Dschadu/Geistwerk-BigCore/PCB.png

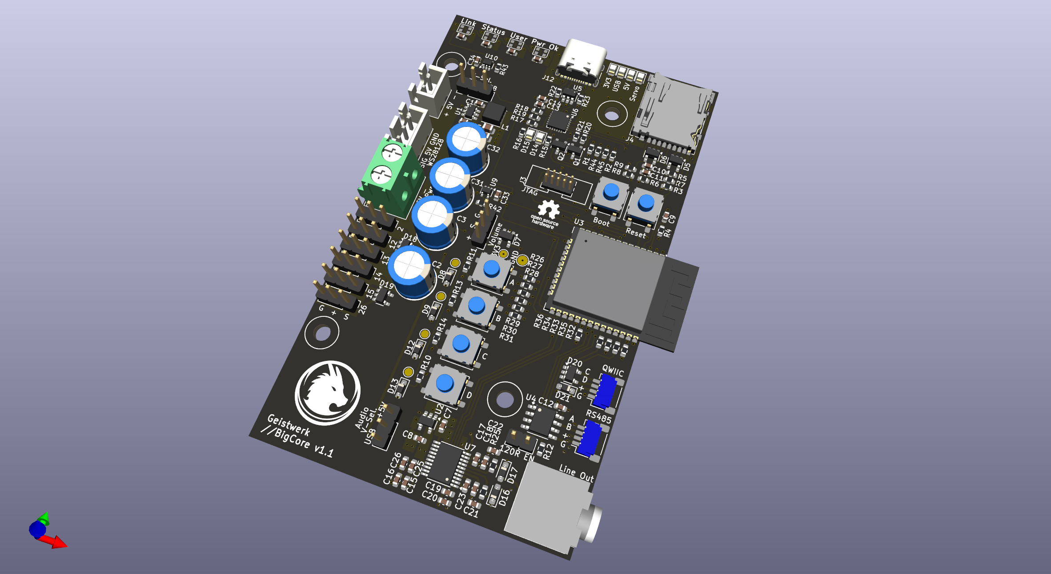
PCB.png
