Dschadu/Geistwerk-BigCore/BigCore.kicad_pcb

## KiCad design BigCore.kicad_pcb (2026-05-09)

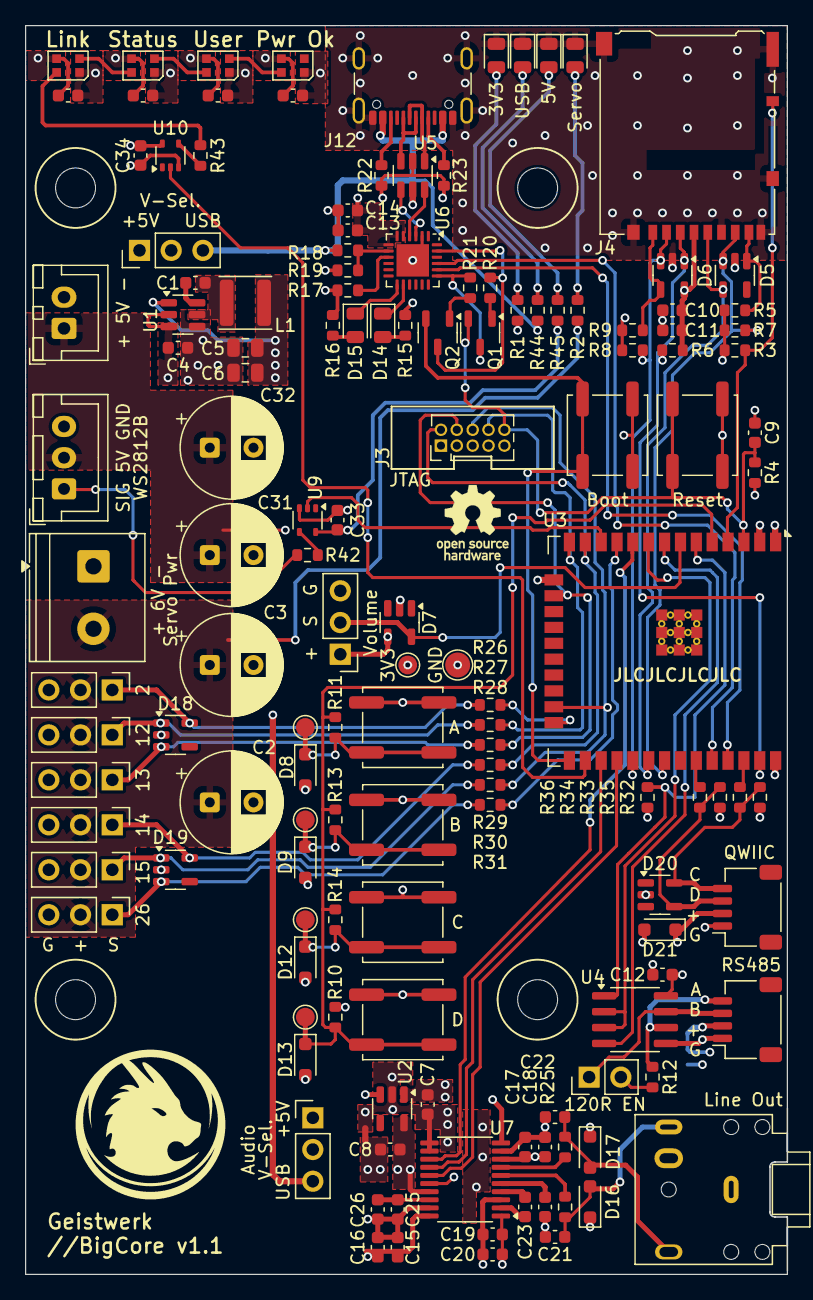
[picture p10: board BigCore.kicad_pcb from above]

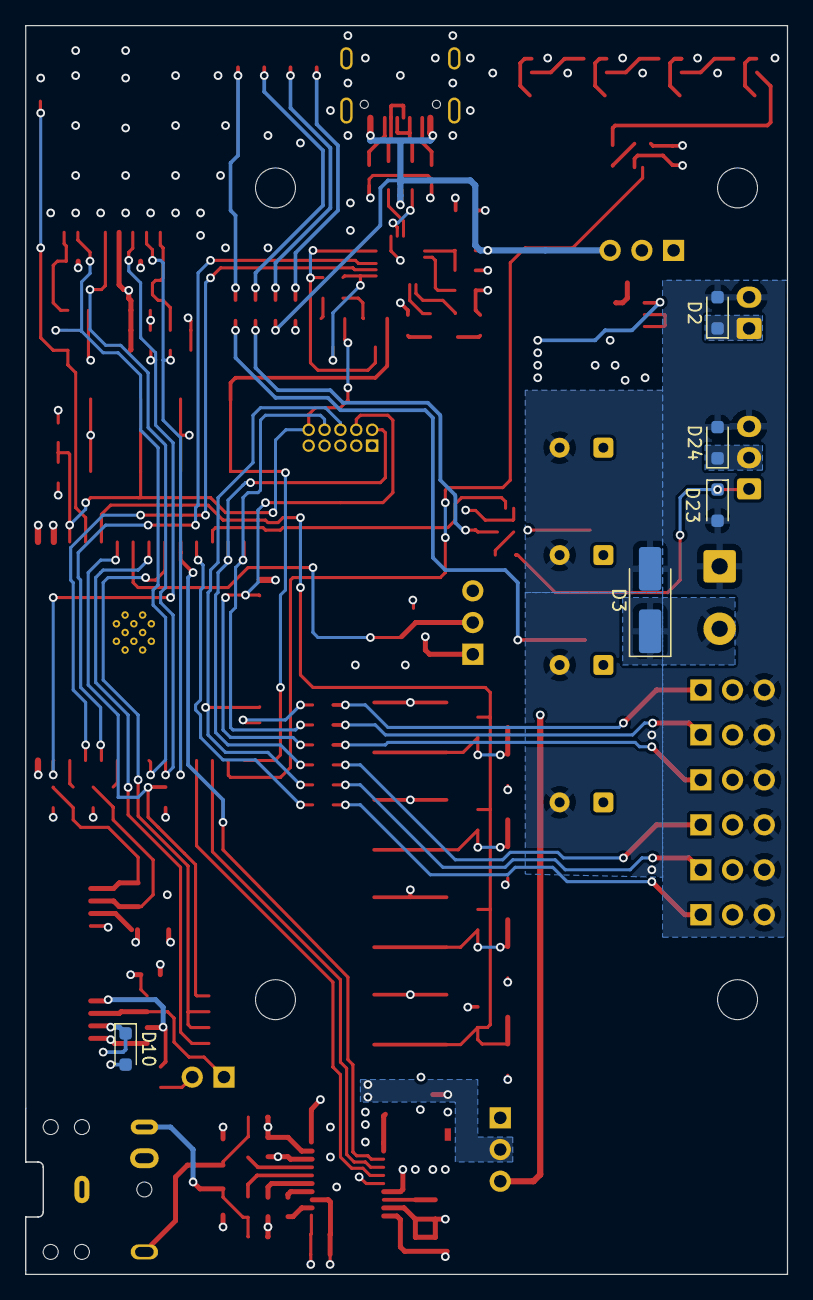
[picture p11: board BigCore.kicad_pcb from below]

Board: 4 copper layers, 61.0 x 100.0 mm, 151 parts (5 on the bottom side), 89 nets.

Parts:
C1, C9, C10, C12, C13, C15, C17, C19, C25, C33, C34, C35, C36, C37, C38: 100n; C_0603_1608Metric
C2, C3, C31, C32: 470µ; CP_Radial_D8.0mm_P3.50mm
C4, C11, C14, C16, C18, C20, C26: 10µ; C_0603_1608Metric
C5, C6: 22µ; C_0805_2012Metric
C7, C8: 1µ; C_0603_1608Metric
C21, C22: 2.2n; C_0603_1608Metric
C23, C24: 2.2µ; C_0603_1608Metric
D1, D4, D29, D30: Green; LED_0805_2012Metric
D2, D23, D24: TSD05DYFR; D_SOD-323_HandSoldering
D3: SMCJ13A; D_SMA_Handsoldering
D5, D6, D18, D19: ESDS314; SOT-23-5
D7, D20: ESDS312; SOT-23-5
D8, D9, D10, D12, D13, D21: ESDS311DYFR; D_SOD-323_HandSoldering
D14: TX; LED_0805_2012Metric
D15: RX; LED_0805_2012Metric
D16, D17: SD08LCC; D_SOD-323_HandSoldering
D25, D26, D27, D28: WS2812B; LED_WS2812B-2020_PLCC4_2.0x2.0mm
H1, H2, H3, H4: MountingHole; MountingHole_3.2mm_M3
H5: Logo_Open_Hardware_Small; OSHW-Logo_5.7x6mm_SilkScreen
J1: 5V In; JST_XH_B2B-XH-A_1x02_P2.50mm_Vertical
J2: Vdrive In; TerminalBlock_Phoenix_PT-1,5-2-5.0-H_1x02_P5.00mm_Horizontal
J3: JTAG; PinHeader_2x05_P1.27mm_Vertical
J4: DM3AT-SF-PEJM5; microSD_HC_Hirose_DM3AT-SF-PEJM5
J5: Volume; PinHeader_1x03_P2.54mm_Vertical
J6: Btn 0; TestPoint_Pad_D1.5mm
J7: RS485; JST_SH_SM04B-SRSS-TB_1x04-1MP_P1.00mm_Horizontal
J8: Btn 1; TestPoint_Pad_D1.5mm
J9: Btn 2; TestPoint_Pad_D1.5mm
J10: Btn 3; TestPoint_Pad_D1.5mm
J11: GND; TestPoint_Pad_D2.0mm
J12: USB_C_Receptacle_USB2.0; USB_C_Receptacle_GCT_USB4105-xx-A_16P_TopMnt_Horizontal
J13: Line Out; Jack_3.5mm_CUI_SJ1-3524N_Horizontal
J14: Servo 01; PinHeader_1x03_P2.54mm_Vertical
J15: Servo 02; PinHeader_1x03_P2.54mm_Vertical
J16: Servo 03; PinHeader_1x03_P2.54mm_Vertical
J17: Servo 04; PinHeader_1x03_P2.54mm_Vertical
J18: Servo 05; PinHeader_1x03_P2.54mm_Vertical
J19: Servo 06; PinHeader_1x03_P2.54mm_Vertical
J20: I2C; JST_SH_SM04B-SRSS-TB_1x04-1MP_P1.00mm_Horizontal
J22: WS2812; JST_XH_B3B-XH-A_1x03_P2.50mm_Vertical
JP1: RS485; PinHeader_1x02_P2.54mm_Vertical
JP2: 5V Selection Digital; PinHeader_1x03_P2.54mm_Vertical
JP3: 5V Selection Analog; PinHeader_1x03_P2.54mm_Vertical
L1: 2,2µ; L_APV_ANR4020
NT1: NetTie_2; NetTie-2_SMD_Pad0.5mm
Q1, Q2: SS8050-G; SOT-23-3
R1, R12, R15, R16, R42, R43: 120; R_0603_1608Metric
R2, R24, R25, R44, R45: 470; R_0603_1608Metric
R3, R4, R5, R6, R7, R8, R9, R20, R21, R36: 10k; R_0603_1608Metric
R10, R17: 1k; R_0603_1608Metric
R11: 4,99k; R_0603_1608Metric
R13: 1,15k; R_0603_1608Metric
R14: 300; R_0603_1608Metric
R18: 22.1k; R_0603_1608Metric
R19: 47.5k; R_0603_1608Metric
R22, R23: 5,1k; R_0603_1608Metric
R26, R27, R28, R29, R30, R31, R34, R35: 33; R_0603_1608Metric
R32, R33: 1.6k; R_0603_1608Metric
SW1: Reset; SW_Push_1P1T_NO_CK_KSC7xxJ
SW2: Boot; SW_Push_1P1T_NO_CK_KSC7xxJ
SW3: Btn 0; SW_Push_1P1T_NO_CK_KSC7xxJ
SW4: Btn 1; SW_Push_1P1T_NO_CK_KSC7xxJ
SW5: Btn 2; SW_Push_1P1T_NO_CK_KSC7xxJ
SW6: Btn 3; SW_Push_1P1T_NO_CK_KSC7xxJ
TP1: +3V3; TestPoint_Pad_D1.5mm
U1: AP63203WU; TSOT-23-6
U2: AP2112K-3.3; SOT-23-5
U3: ESP32-WROOM-32E
U4: ST3485EBDR; SOIC-8_3.9x4.9mm_P1.27mm
U5: USBLC6-2SC6; SOT-23-6
U6: CP2102N-Axx-xQFN24; QFN-24-1EP_4x4mm_P0.5mm_EP2.6x2.6mm
U7: PCM5102A; TSSOP-20_4.4x6.5mm_P0.65mm
U9, U10: 74AHCT1G17; SOT-353_SC-70-5

Connections:
+3.3V: C5.1, C6.1, C10.1, C11.1, C12.1, C13.1, C14.1, C15.1, C16.1, D6.5 (K), D7.4 (K), D10.1 (K), D21.1 (K), J3.1, J4.4 (VDD), J5.1, J7.2, J20.2, L1.2, R1.1, R3.1, R4.1, R5.1, R6.1, R7.1, R8.1, R9.1, R10.1, R15.1, R16.1, R17.1, R32.1, R33.1, R36.1, TP1.1, U1.1 (FB), U3.2 (VDD), U4.8 (VCC), U6.5 (VIO), U6.6 (VDD), U6.7 (VREGIN), U7.20 (DVDD)
+3.3VA: C8.1, C17.1, C18.1, C19.1, C20.1, U2.5 (VOUT), U7.1 (CPVDD), U7.8 (AVDD), U7.17 (XSMT)
+5V: C31.1, C32.1, C33.1, D2.1 (K), D24.1 (K), J1.1, J22.2, JP2.1 (A), JP3.1 (A), R45.1, U9.5 (VCC)
+5VD: C4.1, C34.1, C35.1, C36.1, C37.1, C38.1, D25.1 (VDD), D26.1 (VDD), D27.1 (VDD), D28.1 (VDD), JP2.2 (C), U1.2 (EN), U1.3 (IN), U10.5 (VCC)
/Controller/BOOT: Q2.2 (C), SW2.1, U3.25 (IO0)
/Controller/Buttons: D13.1 (K), J10.1, R10.2, R11.1, R13.1, R14.1, SW6.2, U3.5 (SENSOR_VN)
/Controller/EN: C9.1, J3.10, Q1.2 (C), R4.2, SW1.1, U3.3 (EN)
/Controller/I2S_BitClock: U3.10 (IO25), U7.13 (BCK)
/Controller/I2S_Data: U3.27 (IO16), U7.14 (DIN)
/Controller/I2S_LeftRightClock: U3.28 (IO17), U7.15 (LRCK)
/Controller/LED_STATUS: U3.26 (IO4), U10.2
/Controller/RS485_A: J7.4, R12.2, U4.6 (A)
/Controller/RS485_B: J7.3, JP1.1 (A), U4.7 (B)
/Controller/RS485_D: U3.8 (IO32), U4.4 (D)
/Controller/RS485_R: R36.2, U3.6 (IO34), U4.1 (R)
/Controller/RS485_~REDE: U3.9 (IO33), U4.2 (~RE), U4.3 (DE)
/Controller/RXD: U3.34 (RXD0/IO3), U6.21 (TXD)
/Controller/SCL: R35.1, U3.36 (IO22)
/Controller/SDA: R34.1, U3.33 (IO21)
/Controller/SD_CD: D6.3 (K), J4.2 (DAT3/CD), R8.2, U3.29 (IO5)
/Controller/SD_CLK: D5.4 (K), J4.5 (CLK), U3.30 (IO18)
/Controller/SD_CMD: D6.1 (K), J4.3 (CMD), R6.2, U3.37 (IO23)
/Controller/SD_DAT0: D5.3 (K), J4.7 (DAT0), R7.2, U3.31 (IO19)
/Controller/SD_Detect: J4.10 (DET_A), R3.2, U3.4 (SENSOR_VP)
/Controller/Servo_01: R26.1, U3.24 (IO2)
/Controller/Servo_02: J3.8, R27.1, U3.14 (IO12)
/Controller/Servo_03: J3.4, R28.1, U3.16 (IO13)
/Controller/Servo_04: J3.2, R29.1, U3.13 (IO14)
/Controller/Servo_05: J3.6, R30.1, U3.23 (IO15)
/Controller/Servo_06: R31.1, U3.11 (IO26)
/Controller/TXD: U3.35 (TXD0/IO1), U6.20 (RXD)
/Controller/Volume: D7.5 (K), J5.2, U3.7 (IO35)
/Controller/WS2812_Bus: U3.12 (IO27), U9.2
/Power Supply/5VA_In: C7.1, JP3.2 (C), U2.1 (VIN), U2.3 (EN)
GND: C2.2, C3.2, C4.2, C5.2, C6.2, C7.2, C9.2, C10.2, C11.2, C12.2, C13.2, C14.2, C15.2, C16.2, C25.2, C26.2, C31.2, C32.2, C33.2, C34.2, C35.2, C36.2, C37.2, C38.2, D1.1 (K), D2.2 (A), D3.2 (A), D4.1 (K), D5.2 (A), D6.2 (A), D7.2 (A), D8.2 (A), D9.2 (A), D10.2 (A), D12.2 (A), D13.2 (A), D18.2 (A), D19.2 (A), D20.2 (A), D21.2 (A), D23.2 (A), D24.2 (A), D25.3 (VSS), D26.3 (VSS), D27.3 (VSS), D28.3 (VSS), D29.1 (K), D30.1 (K), J1.2, J2.1, J3.3, J3.5, J3.7, J3.9, J4.6 (VSS), J4.9 (DET_B), J4.11 (SHIELD), J5.3, J7.1, J11.1, J12.A1 (GND), J12.A12 (GND), J12.B1 (GND), J12.B12 (GND), J12.S1 (SHIELD), J14.3, J15.3, J16.3, J17.3, J18.3, J19.3, J20.1, J22.3, NT1.1, R19.2, R22.1, R23.1, SW1.2, SW2.2, SW3.1, SW4.1, SW5.1, SW6.1, U1.4 (GND), U2.2 (GND), U3.1 (GND), U3.15 (GND), U3.38 (GND), U3.39 (GND), U4.5 (GND), U5.2 (GND), U6.2 (GND), U6.25 (GND), U7.10 (DEMP), U7.11 (FLT), U7.12 (SCK), U7.16 (FMT), U7.19 (DGND), U9.3 (GND), U10.3 (GND)
GNDA: C8.2, C17.2, C18.2, C19.2, C20.2, C21.2, C22.2, C24.2, D16.1 (A1), D17.1 (A1), J13.S, NT1.2, U7.3 (CPGND), U7.9 (AGND)
unnamed: D1.2 (A), R2.2
unnamed: D4.2 (A), R1.2
unnamed: D8.1 (K), J6.1, R11.2, SW3.2
unnamed: D9.1 (K), J8.1, R13.2, SW4.2
unnamed: D12.1 (K), J9.1, R14.2, SW5.2
unnamed: D14.2 (A), R15.2
unnamed: D14.1 (K), U6.14 (~TXT/GPIO.0)
unnamed: D15.2 (A), R16.2
unnamed: D15.1 (K), U6.13 (~RXT/GPIO.1)
unnamed: C21.1, D16.2 (A2), J13.T, R24.2
unnamed: C22.1, D17.2 (A2), J13.R, R25.2
unnamed: D23.1 (K), J22.1, R42.2
unnamed: D25.4 (DIN), R43.2
unnamed: D25.2 (DOUT), D26.4 (DIN)
unnamed: D26.2 (DOUT), D27.4 (DIN)
unnamed: D27.2 (DOUT), D28.4 (DIN)
unnamed: D29.2 (A), R44.2
unnamed: D30.2 (A), R45.2
unnamed: D5.1 (K), J4.8 (DAT1), R5.2
unnamed: D6.4 (K), J4.1 (DAT2), R9.2
unnamed: J12.A5 (CC1), R23.2
unnamed: J12.B5 (CC2), R22.2
unnamed: J12.A6 (D+), J12.B6 (D+), U5.3 (I/O2)
unnamed: J12.A7 (D-), J12.B7 (D-), U5.1 (I/O1)
unnamed: D18.5 (K), J14.1, R26.2
unnamed: D18.1 (K), J15.1, R27.2
unnamed: D18.3 (K), J16.1, R28.2
unnamed: D19.5 (K), J17.1, R29.2
unnamed: D19.1 (K), J18.1, R30.2
unnamed: D19.3 (K), J19.1, R31.2
unnamed: D20.4 (K), J20.3, R33.2, R34.2
unnamed: D20.5 (K), J20.4, R32.2, R35.2
unnamed: JP1.2 (B), R12.1
unnamed: Q1.1 (B), R20.2
unnamed: Q1.3 (E), R21.1, U6.19 (~RTS)
unnamed: Q2.1 (B), R21.2
unnamed: Q2.3 (E), R20.1, U6.23 (~DTR)
unnamed: R42.1, U9.4
unnamed: R43.1, U10.4
unnamed: C1.2, U1.6 (BST)
unnamed: C1.1, L1.1, U1.5 (SW)
unnamed: U5.4 (I/O2), U6.3 (D+)
unnamed: U5.6 (I/O1), U6.4 (D-)
unnamed: R18.2, R19.1, U6.8 (VBUS)
unnamed: R17.2, U6.9 (~RST)
unnamed: C23.2, U7.4 (CAPM)
unnamed: C23.1, U7.2 (CAPP)
unnamed: C25.1, C26.1, U7.18 (LDOO)
unnamed: R24.1, U7.6 (OUTL)
unnamed: R25.1, U7.7 (OUTR)
unnamed: C24.1, U7.5 (VNEG)
VBUS: J12.A4 (VBUS), J12.A9 (VBUS), J12.B4 (VBUS), J12.B9 (VBUS), JP2.3 (B), JP3.3 (B), R18.1, R44.1, U5.5 (VBUS)
Vdrive: C2.1, C3.1, D3.1 (K), J2.2, J14.2, J15.2, J16.2, J17.2, J18.2, J19.2, R2.1
