Dschadu/Geistwerk-BigCore/(commit log)

2026-05-09 Changed some labes, fixed RS485 Line Fixed Servo-Pin Header and Audio-Pin Header label. Added 10k Pullup to RS485 R-Line
    [BigCore.kicad_pcb, controller.kicad_sch]
2026-06-26 Updated Docs
    Updated PCB image
    Updated schematic
    Updated BOM
